wings-of-liberty-zdy/Adeptus_Mechanicus/README.md

# 重庆大学CRTC:弹丸收集小车比赛

## 比赛简介
比赛核心是机器人之间的资源争夺。参赛队伍需自行设计、开发和制作符合比赛规范的1-2台机器人参
与比赛，在比赛中控制机器人在限定的空间和时间范围内尽可能多地收集和占有有限的道具资源。最终持有道具数
量较多的一方获得比赛胜利。

具体规则:

场地内小球触发装置启动后,1,2号机器人开始收集小球,比赛结束时，**比赛双方1号机器人携带弹丸数更多者胜出**。
双方1号机器人携带弹丸数一致时，则双方所有机器人携带总弹丸数更多者胜出。
若此时双方所有机器人携带总弹丸数仍一致，则本局比赛被判为平局。

## 团队成员和分工
电控组:李仕平,朱德远
机械组:蒋德行,吴扬,陈威

## 项目状态:
9--10.14:前期基础培训和[收集功能部件构思]()

10.14-10.:方案设计阶段-[机械结构分功能块设计]()
