wings-of-liberty-zdy/Adeptus_Mechanicus/(commit log)

2025-10-05 [代码]PS2连接代码更新
2025-10-19 Add 收集装置 section to program design document
2025-10-23 [代码]修改PS2连接代码
2025-10-25 Revise ball collection vehicle design document
    Updated the design document for the ball collection vehicle, including changes to the collection mechanism, height restrictions, and optimization of the fan blade structure.
2025-10-25 Optimize storage device design and structure
    Redesign storage device to improve functionality and prevent ball loss.
2025-10-25 Enhance power system design section in documentation
    Added detailed design considerations for the power system and wheel installation method in the mechanical design document.
2025-10-25 Add design document for electric control system
    Document the design and development process of the electric control system for the bullet collection vehicle, covering software learning, tool selection, and collaboration framework.
2025-10-25 Expand documentation for chassis control module development
    Added detailed documentation on chassis control module development, including functionality, development history, core issues, solutions, and verification processes.
2025-10-25 Add PS2 controller communication module details
    Document the development process of the PS2 controller communication module with STM32, including functionality, hardware connections, code implementation, and problem-solving strategies.
2025-10-25 Document collection device control module development
    Added section on collection device control module development, including actuator control schemes and core issues faced during development.
2025-10-26 [图片]上传收集装置建模图片
2025-10-26 [图片]更改收集装置建模照片文件名
2025-10-26 Revise弹丸收集小车 mechanical design document
    Updated the mechanical design document for the弹丸收集小车, including sections on collection device design, storage device design, and power device design. Enhanced details on the design process, challenges faced, and solutions implemented.
2025-10-26 添加收集装置图片
